dangyogi/midi-expression/README.md

# midi-expression
Combine custom midi expression board with midi-files for real-time performances.
