dangyogi/midi-expression/(list of files, drawings)

Other design files:
exp_console/PCBs/PCB_PCB_LED Controller_2023-10-30.json
