dangyogi/midi-expression/exp_console/PCBs/column-bus/column-bus.kicad_pcb

## KiCad design exp_console/PCBs/column-bus/column-bus.kicad_pcb (2022-09-17)

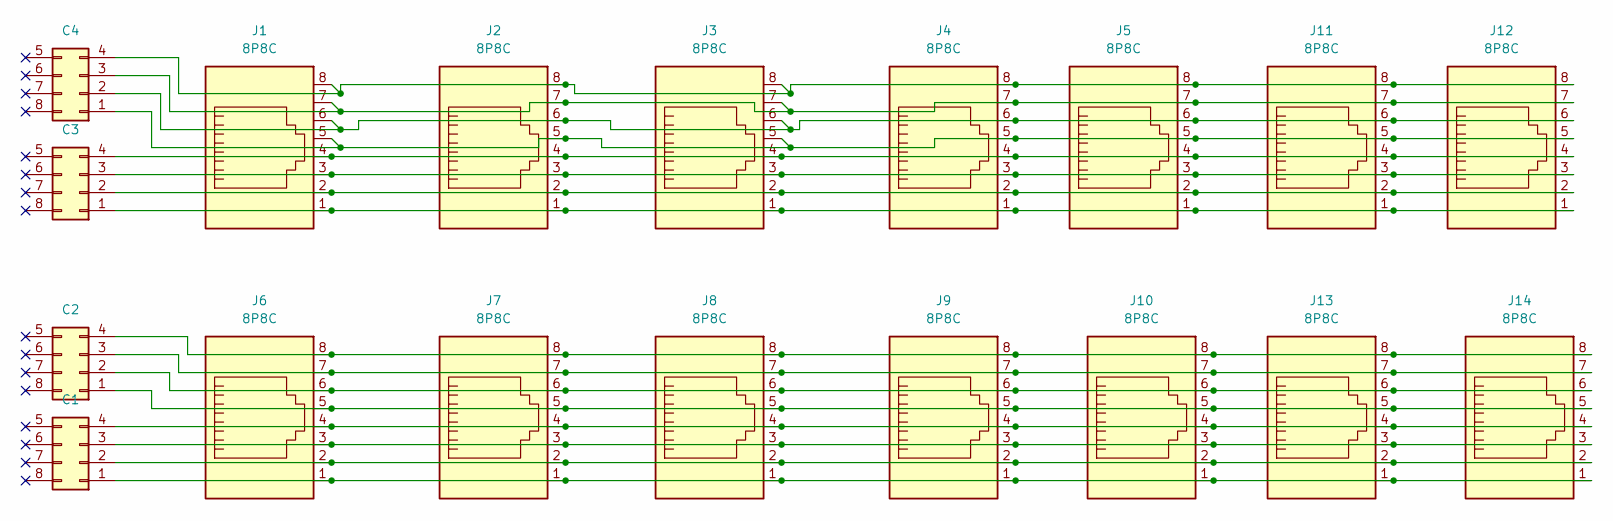
[picture p1: schematic column-bus.kicad_sch]

Parts:
C1, C2, C3, C4: Conn_02x04_Counter_Clockwise; Weidmuller-4-vertical
J1, J2, J3, J4, J5, J6, J7, J8, J9, J10, J11, J12, J13, J14: 8P8C; Wurth-8P8C-Vertical

Connections:
unnamed: C1.1, J6.1, J7.1, J8.1, J9.1, J10.1, J13.1, J14.1
unnamed: C1.2, J6.2, J7.2, J8.2, J9.2, J10.2, J13.2, J14.2
unnamed: C1.3, J6.3, J7.3, J8.3, J9.3, J10.3, J13.3, J14.3
unnamed: C1.4, J6.4, J7.4, J8.4, J9.4, J10.4, J13.4, J14.4
unnamed: C2.1, J6.5, J7.5, J8.5, J9.5, J10.5, J13.5, J14.5
unnamed: C2.2, J6.6, J7.6, J8.6, J9.6, J10.6, J13.6, J14.6
unnamed: C2.3, J6.7, J7.7, J8.7, J9.7, J10.7, J13.7, J14.7
unnamed: C2.4, J6.8, J7.8, J8.8, J9.8, J10.8, J13.8, J14.8
unnamed: C3.1, J1.1, J2.1, J3.1, J4.1, J5.1, J11.1, J12.1
unnamed: C3.2, J1.2, J2.2, J3.2, J4.2, J5.2, J11.2, J12.2
unnamed: C3.3, J1.3, J2.3, J3.3, J4.3, J5.3, J11.3, J12.3
unnamed: C3.4, J1.4, J2.4, J3.4, J4.4, J5.4, J11.4, J12.4
unnamed: C4.1, J1.5, J2.5, J3.5, J4.5, J5.5, J11.5, J12.5
unnamed: C4.2, J1.6, J2.6, J3.6, J4.6, J5.6, J11.6, J12.6
unnamed: C4.3, J1.7, J2.7, J3.7, J4.7, J5.7, J11.7, J12.7
unnamed: C4.4, J1.8, J2.8, J3.8, J4.8, J5.8, J11.8, J12.8

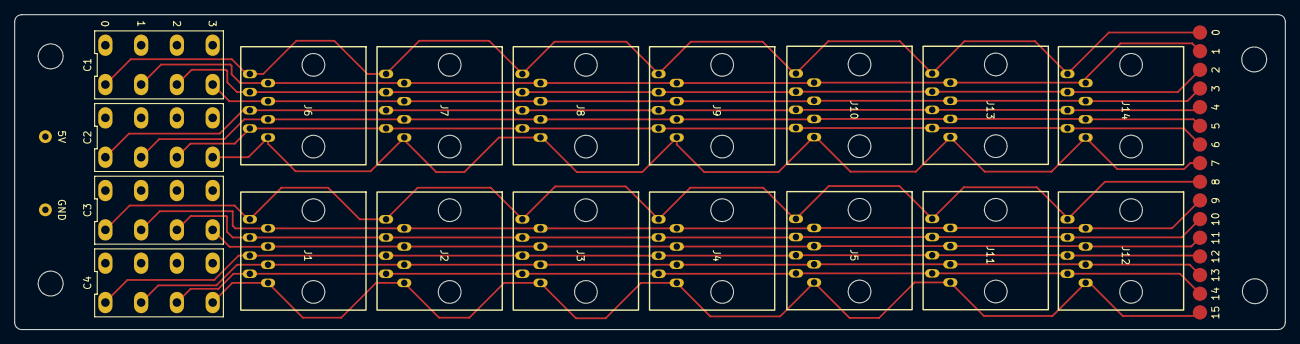
[picture p2: board column-bus.kicad_pcb from above]

Board: 2 copper layers, 177.7 x 44.0 mm, 18 parts (0 on the bottom side), 16 nets.
