dangyogi/midi-expression/exp_console/PCBs/numeric-displays/numeric-displays.kicad_pcb

## KiCad design exp_console/PCBs/numeric-displays/numeric-displays.kicad_pcb (2022-09-17)

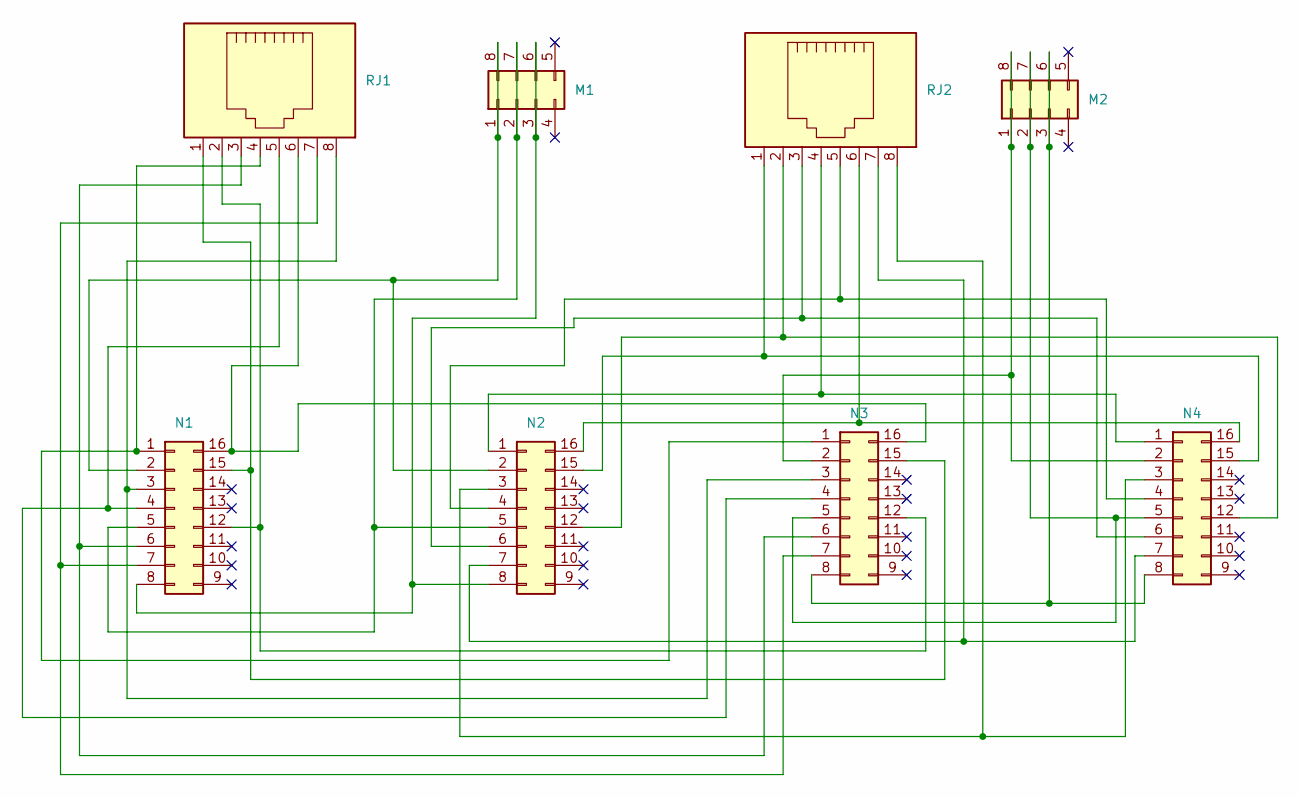
[picture p3: schematic numeric-displays.kicad_sch]

Parts:
M1, M2: Conn_02x04_Counter_Clockwise; Weidmuller-4-vertical
N1, N2, N3, N4: Conn_02x08_Counter_Clockwise; DIP-16_W7.62mm_Socket_LongPads
RJ1, RJ2: 8P8C; Wurth-8P8C-Vertical

Connections:
unnamed: M1.1, M1.8, N1.2, N2.2
unnamed: M1.2, M1.7, N1.5, N2.5
unnamed: M1.3, M1.6, N1.8, N2.8
unnamed: M2.1, M2.8, N3.2, N4.2
unnamed: M2.2, M2.7, N3.5, N4.5
unnamed: M2.3, M2.6, N3.8, N4.8
unnamed: N1.1, N3.1, RJ1.4
unnamed: N1.3, N3.3, RJ1.8
unnamed: N1.4, N3.4, RJ1.5
unnamed: N1.6, N3.6, RJ1.3
unnamed: N1.7, N3.7, RJ1.7
unnamed: N1.12, N3.12, RJ1.2
unnamed: N1.15, N3.15, RJ1.1
unnamed: N1.16, N3.16, RJ1.6
unnamed: N2.1, N4.1, RJ2.4
unnamed: N2.3, N4.3, RJ2.8
unnamed: N2.4, N4.4, RJ2.5
unnamed: N2.6, N4.6, RJ2.3
unnamed: N2.7, N4.7, RJ2.7
unnamed: N2.12, N4.12, RJ2.2
unnamed: N2.15, N4.15, RJ2.1
unnamed: N2.16, N4.16, RJ2.6

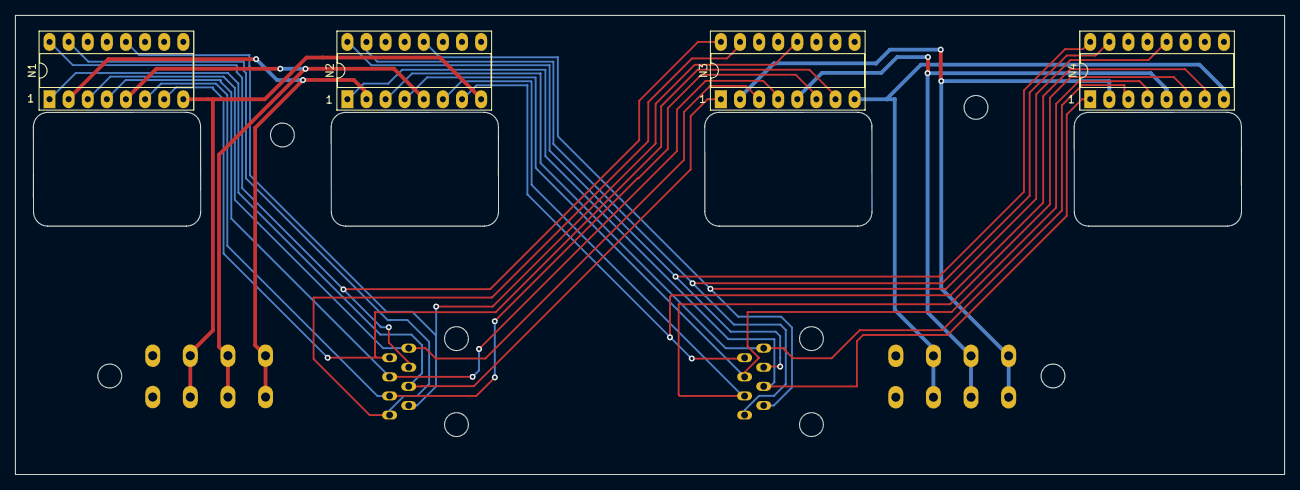
[picture p4: board numeric-displays.kicad_pcb from above]

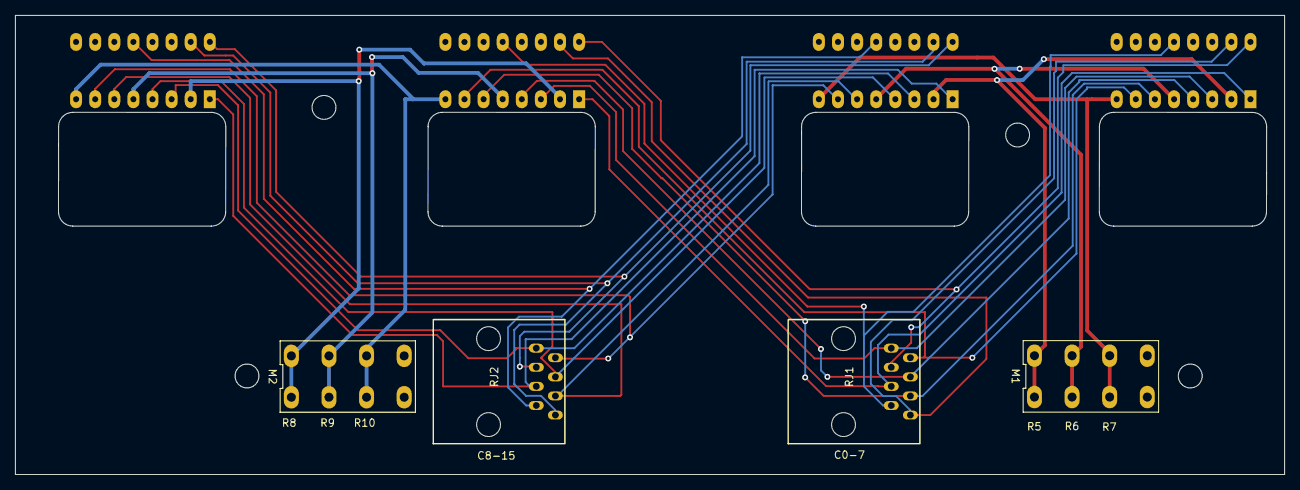
[picture p5: board numeric-displays.kicad_pcb from below]

Board: 2 copper layers, 168.7 x 61.0 mm, 8 parts (4 on the bottom side), 22 nets.
