dangyogi/midi-expression/exp_console/PCBs/alpha-displays/alpha-displays.kicad_pcb

## KiCad design exp_console/PCBs/alpha-displays/alpha-displays.kicad_pcb (2022-09-17)

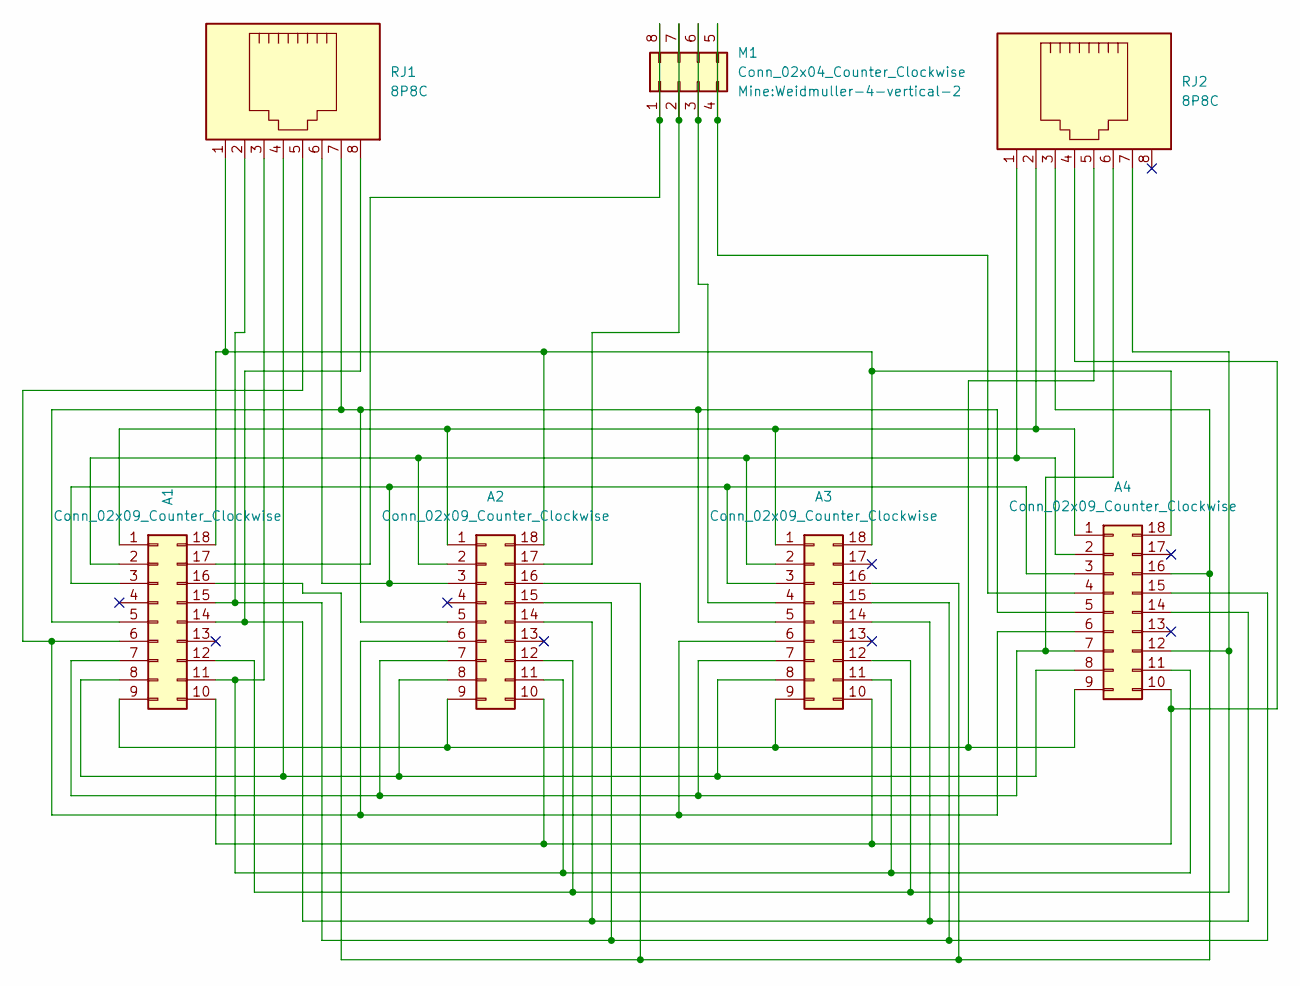
[picture p6: schematic alpha-displays.kicad_sch]

Parts:
A1, A2, A3, A4: Conn_02x09_Counter_Clockwise; DIP-18_W7.62mm_Socket_LongPads
M1: Conn_02x04_Counter_Clockwise; Weidmuller-4-vertical-2
RJ1, RJ2: 8P8C; Wurth-8P8C-Vertical

Connections:
unnamed: A1.1, A2.1, A3.1, A4.1, RJ2.2
unnamed: A1.2, A2.2, A3.2, A4.2, RJ2.1
unnamed: A1.3, A2.3, A3.3, A4.3, RJ1.6
unnamed: A1.5, A2.5, A3.5, A4.5, RJ1.7
unnamed: A1.6, A2.6, A3.6, A4.6, RJ1.5
unnamed: A1.7, A2.7, A3.7, A4.7, RJ2.6
unnamed: A1.8, A2.8, A3.8, A4.8, RJ1.4
unnamed: A1.9, A2.9, A3.9, A4.9, RJ2.5
unnamed: A1.10, A2.10, A3.10, A4.10, RJ2.4
unnamed: A1.11, A2.11, A3.11, A4.11, RJ1.3
unnamed: A1.12, A2.12, A3.12, A4.12, RJ2.7
unnamed: A1.14, A2.14, A3.14, A4.14, RJ1.8
unnamed: A1.15, A2.15, A3.15, A4.15, RJ1.2
unnamed: A1.16, A2.16, A3.16, A4.16, RJ2.3
unnamed: A1.17, M1.1, M1.8
unnamed: A1.18, A2.18, A3.18, A4.18, RJ1.1
unnamed: A2.17, M1.2, M1.7
unnamed: A3.4, M1.3, M1.6
unnamed: A4.4, M1.4, M1.5

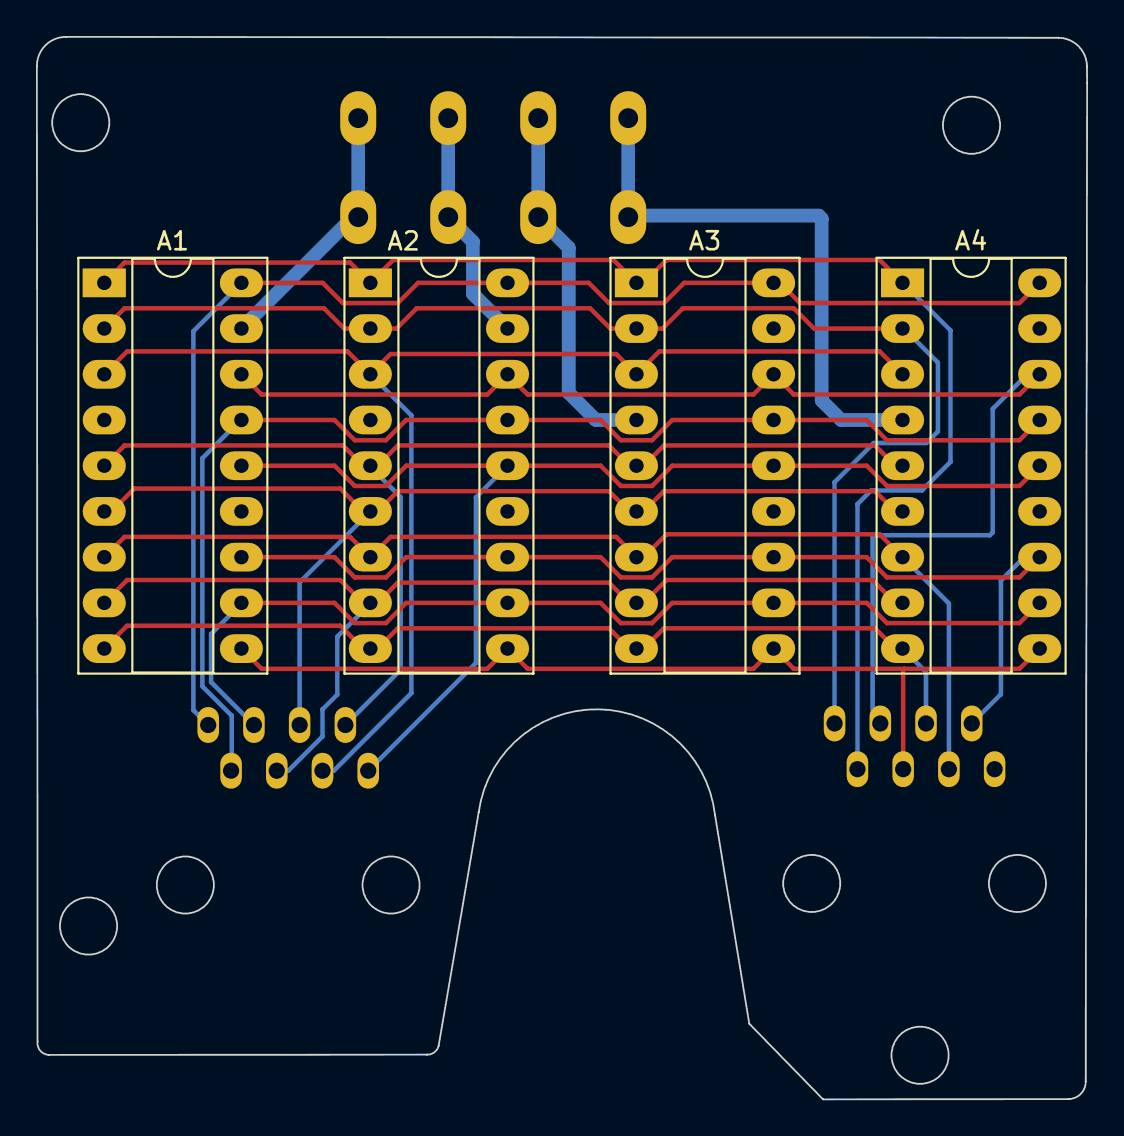
[picture p7: board alpha-displays.kicad_pcb from above]

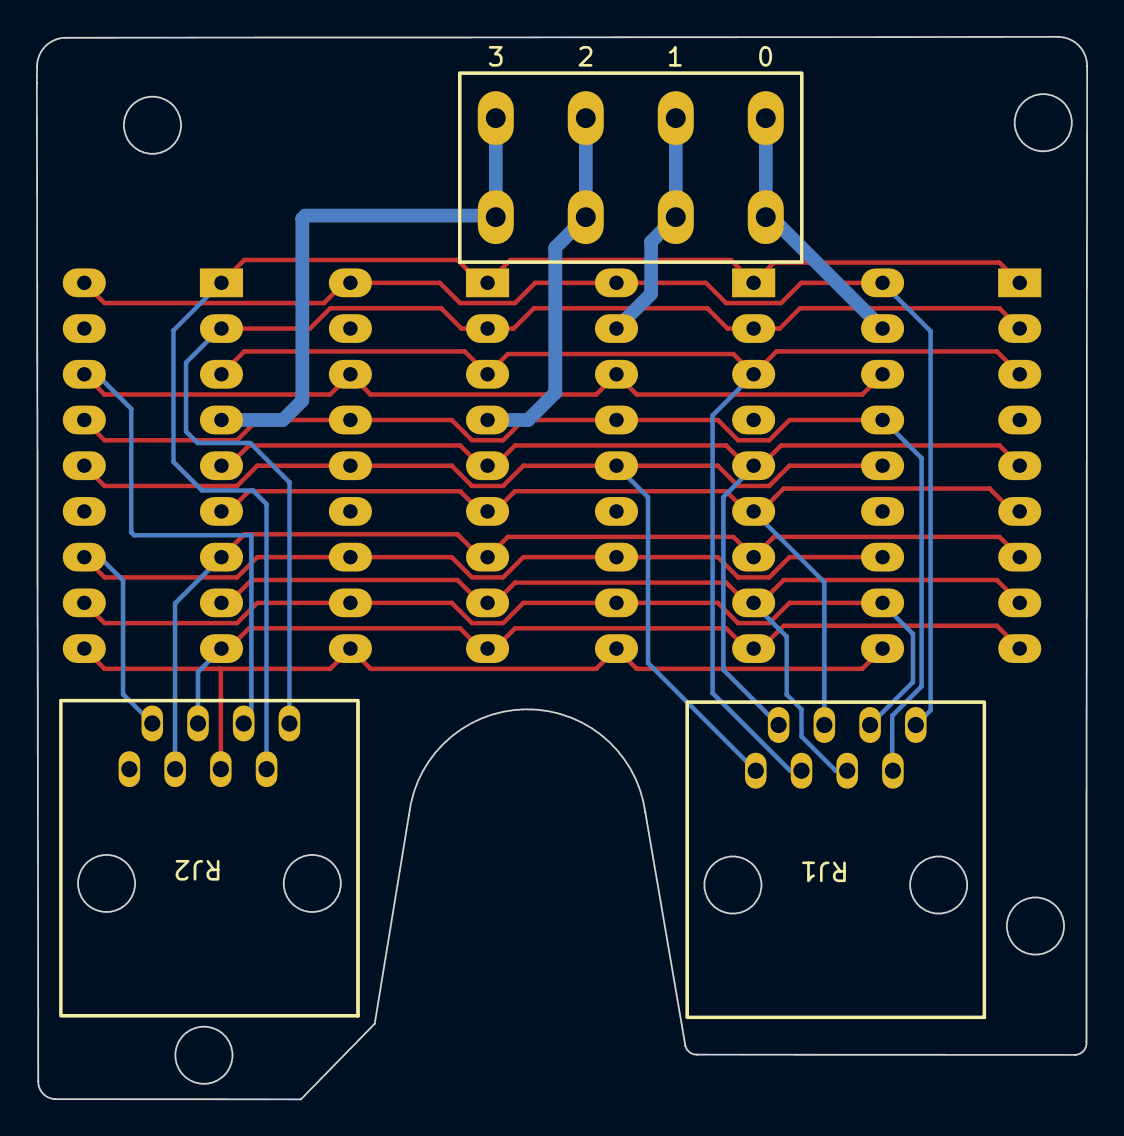
[picture p8: board alpha-displays.kicad_pcb from below]

Board: 2 copper layers, 58.3 x 59.0 mm, 7 parts (3 on the bottom side), 19 nets.
