dangyogi/midi-expression/data/devices.yaml

# devices.yaml

---

I/O Expander:
  part-number: MCP23016-I/SP
  ordered-from: mouser.com
  price: 
  current-drive: 25mA
  supply-voltage: [2, 5.5]
  num-rows: 2
  num-onhand: 10
  socket:
    part-number: 1-2199298-9
    ordered-from: mouser.com
    price: 0.78
    num-onhand: 10
    num-needed: 1
  I2C:
    addr: [0, 1, 0, 0, A2, A1, A0]
    init: []
    commands:
      0x00:
        name: Access GP0
        value-on-reset: [0, 0, 0, 0, 0, 0, 0, 0]
      0x01:
        name: Access GP1
        value-on-reset: [0, 0, 0, 0, 0, 0, 0, 0]
      0x02:
        name: Access OLAT0
        comment: Output Latch Register
        value-on-reset: [0, 0, 0, 0, 0, 0, 0, 0]
      0x03:
        name: Access OLAT1
        comment: Output Latch Register
        value-on-reset: [0, 0, 0, 0, 0, 0, 0, 0]
      0x04:
        name: Access IPOL0
        comment: Input Polarity Register, 1 inverted, 0 not inverted
        value-on-reset: [0, 0, 0, 0, 0, 0, 0, 0]
      0x05:
        name: Access IPOL1
        comment: Input Polarity Register, 1 inverted, 0 not inverted
        value-on-reset: [0, 0, 0, 0, 0, 0, 0, 0]
      0x06:
        name: Access IODIR0
        comment: I/O Direction Register, 1 input, 0 output
        value-on-reset: [1, 1, 1, 1, 1, 1, 1, 1]
      0x07:
        name: Access IODIR1
        comment: I/O Direction Register, 1 input, 0 output
        value-on-reset: [1, 1, 1, 1, 1, 1, 1, 1]
      0x08:
        name: Access INTCAP0
        comment: Interupt Capture Register -- not needed
      0x09:
        name: Access INTCAP1
        comment: Interupt Capture Register -- not needed
      0x0A:
        name: Access IOCON0
        comment: IARES -- Interrupt Activity Resolution, 1 fast sample rate (200uSec), 0 normal sample rate (32mSec)
        bits: [-, -, -, -, -, -, -, IARES]
        value-on-reset: [-, -, -, -, -, -, -, 0]
      0x0B:
        name: Access IOCON1
        bits: [-, -, -, -, -, -, -, IARES]
        value-on-reset: [-, -, -, -, -, -, -, 0]
  fanout-pins: [GP0.0, GP0.1, GP0.2, GP0.3, GP0.4, GP0.5, GP0.6, GP0.7,
                GP1.0, GP1.1, GP1.2, GP1.3, GP1.4, GP1.5, GP1.6, GP1.7]
  pins:
    - name: Vss
      comment: GND
    - name: GP1.0
    - name: GP1.1
    - name: GP1.2
    - name: GP1.3
    - name: INT
      inverted: true
      connect: []
    - name: GP1.4
    - name: Vss
      comment: GND
    - name: CLK
      connect: [[3.9Kohm, Vdd], [33pF, GND]]
    - name: TP
      connect: []
    - name: GP1.5
    - name: GP1.6
    - name: GP1.7
    - name: SCL

    - name: SDA
    - name: A0
    - name: A1
    - name: A2
    - name: Vss
      connect: [[GND]]
    - name: Vdd
      connect: [[.1uF, GND]]
    - name: GP0.0
    - name: GP0.1
    - name: GP0.2
    - name: GP0.3
    - name: GP0.4
    - name: GP0.5
    - name: GP0.6
    - name: GP0.7


I/O Expander Input:
  uses: I/O Expander
  I2C:
    init: []
  pins:
    - name: GP1.0
      connect: [[20Kohm, Vdd]]
    - name: GP1.1
      connect: [[20Kohm, Vdd]]
    - name: GP1.2
      connect: [[20Kohm, Vdd]]
    - name: GP1.3
      connect: [[20Kohm, Vdd]]
    - name: GP1.4
      connect: [[20Kohm, Vdd]]
    - name: GP1.5
      connect: [[20Kohm, Vdd]]
    - name: GP1.6
      connect: [[20Kohm, Vdd]]
    - name: GP1.7
      connect: [[20Kohm, Vdd]]
    - name: GP0.7
      connect: [[20Kohm, Vdd]]
    - name: GP0.6
      connect: [[20Kohm, Vdd]]
    - name: GP0.5
      connect: [[20Kohm, Vdd]]
    - name: GP0.4
      connect: [[20Kohm, Vdd]]
    - name: GP0.3
      connect: [[20Kohm, Vdd]]
    - name: GP0.2
      connect: [[20Kohm, Vdd]]
    - name: GP0.1
      connect: [[20Kohm, Vdd]]
    - name: GP0.0
      connect: [[20Kohm, Vdd]]

I/O Expander Output:
  uses: I/O Expander
  I2C:
    init: [[Access IODIR0, 0x00, 0x00]]
  pins:
    - name: GP1.0
      connect: [[120ohm, series]]
    - name: GP1.1
      connect: [[120ohm, series]]
    - name: GP1.2
      connect: [[120ohm, series]]
    - name: GP1.3
      connect: [[120ohm, series]]
    - name: GP1.4
      connect: [[120ohm, series]]
    - name: GP1.5
      connect: [[120ohm, series]]
    - name: GP1.6
      connect: [[120ohm, series]]
    - name: GP1.7
      connect: [[120ohm, series]]
    - name: GP0.7
      connect: [[120ohm, series]]
    - name: GP0.6
      connect: [[120ohm, series]]
    - name: GP0.5
      connect: [[120ohm, series]]
    - name: GP0.4
      connect: [[120ohm, series]]
    - name: GP0.3
      connect: [[120ohm, series]]
    - name: GP0.2
      connect: [[120ohm, series]]
    - name: GP0.1
      connect: [[120ohm, series]]
    - name: GP0.0
      connect: [[120ohm, series]]

Multiplexer:
  part-number: MAX4617CPE+
  ordered-from: mouser.com
  price: 4.48
  num-onhand: 13
  supply-voltage: [2, 5.5]
  output-pins: [X0, X1, X2, X3, X4, X5, X6, X7]
  num-pins: 8
  num-rows: 2
  socket:
    part-number: 110-47-316-41-001000
    num-pins: 16
    num-onhand: 15
    ordered-from: mouser.com
    price: 1.10
    number-needed: 1
  fanout-pins: [X0, X1, X2, X3, X4, X5, X6, X7]
  pins:
    - name: X4
    - name: X6
    - name: X
    - name: X7
    - name: X5
    - name: ENABLE
      connect: [[GND]]
    - name: N.C.
      connect: []
    - name: GND
      connect: [[GND]]

    - name: C
      comment: MSb
    - name: B
    - name: A
      comment: LSb
    - name: X3
    - name: X0
    - name: X1
    - name: X2
    - name: Vcc
      connect: [[.1uF, GND]]

Counter:
  part-number: CD74HCT161EE4
  mouser-number: 595-CD74HCT161EE4
  ordered-from: mouser.com
  price: 0.62
  supply-voltage: [4.5, 5.5]
  output-pins: [Q0, Q1, Q2, Q3]
  num-pins: 16
  num-rows: 2
  socket:
    part-number: 110-47-316-41-001000
    ordered-from: mouser.com
    price: 1.10
    num-needed: 1
  pins:
    - name: MR
      inverted: true
      comment: master reset, independent of clock, 30nSec pulse width
    - name: CP
      comment: clock, triggers on transition to high, 25nSec pulse width
    - name: P0
      connect: [[GND]]
    - name: P1
      connect: [[GND]]
    - name: P2
      connect: [[GND]]
    - name: P3
      connect: [[GND]]
    - name: PE
      connect: [[Vcc]]
    - name: GND
      connect: [[GND]]

    - name: Vcc
      connect: [[.1uF, GND]]
    - name: TC
      comment: no connection
    - name: Q0
    - name: Q1
    - name: Q2
    - name: Q3
    - name: TE
      connect: [[Vcc]]
    - name: SPE
      inverted: true
      connect: [[Vcc]]

Demultiplexer:
  part-number: SN74HC138N
  mouser-number: 595-SN74HC138N
  ordered-from: mouser.com
  price: 0.60
  supply-voltage: [2, 6]
  comment: address selectable low line out of 8 high outputs
  output-drive: +/- 4mA
  output-pins: [Y0, Y1, Y2, Y3, Y4, Y5, Y6, Y7]
  num-pins: 16
  num-rows: 2
  fanout-pins: [Y0, Y1, Y2, Y3, Y4, Y5, Y6, Y7]
  socket:
    part-number: 110-47-316-41-001000
    ordered-from: mouser.com
    price: 1.10
    number-needed: 1
  pins:
    - name: A
    - name: B
    - name: C
    - name: G2A
      inverted: true
      comment: must be low, or all outputs are high
    - name: G2B
      inverted: true
      comment: must be low, or all outputs are high
    - name: G1
      comment: must be high, or all outputs are high
    - name: Y7
    - name: GND
      connect: [[GND]]

    - name: Y6
    - name: Y5
    - name: Y4
    - name: Y3
    - name: Y2
    - name: Y1
    - name: Y0
    - name: Vcc
      connect: [[.1uF, GND]]

Slide Pot:
  part-number: SLP-50K
  ordered-from: allelectronics.com
  price: 0.50
  num-onhand: 25
  length: 3 3/8
  width: 3/4
  slide-slot-length: 2 5/8
  screw-size: 4-40
  screw-hole-size: 0.116"
  knob:
    part-number: KNB-297
    ordered-from: allelectronics.com
    price: 0.40
  num-rows: 1
  pin-connect: wiper
  pins:
    - name: high-rail
    - name: wiper
    - name: low-rail
      connect: [[GND]]

Rotary Switch:
  part-number: RSW-112
  ordered-from: allelectronics.com
  price: 2.00
  num-onhand: 7
  positions: 12
  fanout-pins: [P1, P2, P3, P4, P5, P6, P7, P8, P9, P10, P11, P12]
  num-rows: 1
  pins:
    - name: P1
    - name: P2
    - name: P3
    - name: P4
    - name: P5
    - name: P6
    - name: P7
    - name: P8
    - name: P9
    - name: P10
    - name: P11
    - name: P12
    - name: wiper
      connect: [[GND]]

Toggle Switch:
  part-number: STS-130
  ordered-from: allelectronics.com
  price: 1.75
  num-onhand: 35
  type: SPST
  num-rows: 1
  hole-size: 0.47"
  open: toggle on slot side
  pin-connect: p1
  pins:
    - name: p1
    - name: p2
      connect: [[+diode, series]]
      comment: positive side of switch

Rotary Encoder:
  part-number: RE-66
  ordered-from: allelectronics.com
  price: 1.75
  num-onhand: 15
  detents: 20
  hole-size: 0.27
  fanout-pins: [A, B, Bt]
  num-rows: 1
  pins:
    - name: A
    - name: center
      connect: [[+diode, series]]
      comment: positive side of switch
    - name: B
    - name: Bt
    - name: Bt2
      connect: [[+diode, series]]
      comment: positive side of switch

LED:
  part-number: LED-10R
  ordered-from: allelectronics.com
  price: 0.10
  num-onhand: 40
  color: red
  brightness: brighter
  hole-size: 3/16
  pin-connect: long
  num-rows: 1
  pins:
    - name: anode
      comment: positive
      connect: []
    - name: cathode
      comment: negative
      connect: [[GND]]

Button:
  part-number: SB4011NOHC
  mouser-number: 633-SB4011NOHC
  ordered-from: mouser.com
  price: 4.51
  num-onhand: 16
  normally: open
  hole-size: 0.47"
  pin-connect: p1
  num-rows: 1
  pins:
    - name: p1
    - name: p2
      connect: [[+diode, series]]
      comment: positive side of switch

LCD:
  part-number: HDM16216H-5-S00S
  ordered-from: mouser.com
  price: 10.10
  num-onhand: 1
  controller: HD44780 or equivalent
  socket:
    part-number: 61301611821
    ordered-from: mouser.com
    price: 0.69
    num-onhand: 1
    num-needed: 1
  num-rows: 1
  pins:
    - name: Vss
      connect: [[GND]]
    - name: Vdd
      connect: [[.1uF, GND]]
    - name: Vl
    - name: RS
    - name: R/W
    - name: E
    - name: D0
    - name: D1
    - name: D2
    - name: D3
    - name: D4
    - name: D5
    - name: D6
    - name: D7
    - name: NC
      connect: []
      comment: no connection
    - name: NC
      connect: []
      comment: no connection

Rotary Pot:
  part-number: P160KNPD-4FC20B10K
  ordered-from: mouser.com
  price: 0.86
  num-onhand: 1
  ohms: 10k
  taper: linear
  num-rows: 1
  pins:
    - name: high-rail
    - name: wiper
    - name: low-rail

Nano Every:
  ordered-from: arduino.cc
  price: 27.90 for 3 pack
  num-onhand: 3
  microcontroller: ATMega4809
  flash: 48KB
  sram: 6KB
  EEPROM: 256B
  voltage: 5V
  max-total-current: 950mA
  max-GPIO-current: 15mA
  max-pin-group-current: 100mA at 125C, 200mA at 25C, source or sink
  pull-up-resistor: 35kohm
  max-spi-clock: 10MHz master, 5MHz slave
  max-i2c-clock: 1MHz
  clock: 16MHz
  embedded-sensors: []
  num-rows: 2
  socket:
    part-number: PRT-16279
    ordered-from: mouser.com
    price: 1.50
    type: female header
    number-needed: 2
  internal:
    # these skip A4 and A5 because they have two internal pins, can get into trouble...
    PA: [D2, D7]
    PB: [D9, D10, D5]
    PC: [TX, RX, D4]
    PD: [A3, A2, A1, A0, A6, A7, AREF]
    PE: [D11, D12, D13, D8]
    PF: [D6, D3]
  pins:
    - name: D13
      comment: built-in LED
      aka: PE2
    - name: 3V3
      comment: max output 200mA
    - name: AREF
      aka: PD7
    - name: A0
      number: 14
      aka: PD3
    - name: A1
      number: 15
      aka: PD2
    - name: A2
      number: 16
      aka: PD1
    - name: A3
      number: 17
      aka: PD0
    - name: A4
      number: 18
      aka: SDA
    - name: A5
      number: 19
      aka: SCL
    - name: A6
      number: 20
      aka: PD4
    - name: A7
      number: 21
      aka: PD5
    - name: 5V
      connect: [[.1uF, GND]]
      comment: max output 1A
    - name: RESET
      inverted: true
      connect: []
    - name: GND
    - name: VIN
      connect: [[12V], [.1uF, GND]]
      comment: 7-18VDC

    - name: TX
      number: 1
      aka: PC4
    - name: RX
      number: 0
      aka: PC5
    - name: RESET
      inverted: true
      connect: []
    - name: GND2
    - name: D2
      aka: PA0
    - name: D3
      aka: PF5
    - name: D4
      aka: PC6
    - name: D5
      aka: PB2
    - name: D6
      aka: PF4
    - name: D7
      aka: PA1
    - name: D8
      aka: PE3
    - name: D9
      aka: PB0
    - name: D10
      aka: PB1
    - name: D11
      aka: PE0
    - name: D12
      aka: PE1

  aka-registers-by-pin:

    - name: D2
      aka: PA0
    - name: D7
      aka: PA1

    - name: D9
      aka: PB0
    - name: D10
      aka: PB1
    - name: D5
      aka: PB2

    - name: TX
      number: 1
      aka: PC4
    - name: RX
      number: 0
      aka: PC5
    - name: D4
      aka: PC6

    - name: A3
      number: 17
      aka: PD0
    - name: A2
      number: 16
      aka: PD1
    - name: A1
      number: 15
      aka: PD2
    - name: A0
      number: 14
      aka: PD3
    - name: A6
      number: 20
      aka: PD4
    - name: A7
      number: 21
      aka: PD5
    - name: AREF
      aka: PD7

    - name: D11
      aka: PE0
    - name: D12
      aka: PE1
    - name: D13
      comment: built-in LED
      aka: PE2
    - name: D8
      aka: PE3

    - name: D6
      aka: PF4
    - name: D3
      aka: PF5


Nano 33 IoT:
  ordered-from: arduino.cc
  price: 19.40
  num-onhand: 3
  microcontroller: SAMD21
  flash: 264KB
  sram: 256KB
  EEPROM: null
  voltage: 3.3V
  clock: 48MHz
  max-i2c-clock: 3.4MHz
  max-GPIO-current: 7mA
  pull-up-resistor: 40kohm
  embedded-sensors: [LSM6DS3]
  num-rows: 2
  socket:
    part-number: PRT-16279
    ordered-from: mouser.com
    price: 1.50
    type: female header
    number-needed: 2
  pins:
    - name: D13
      aka: PA17
      comment: built-in LED
    - name: 3V3
    - name: AREF
      aka: PA03
    - name: A0
      aka: PA02
      number: 14
    - name: A1
      aka: PB02
      number: 15
    - name: A2
      aka: PA11
      number: 16
    - name: A3
      aka: PA10
      number: 17
    - name: A4
      number: 18
      aka: SDA
    - name: A5
      number: 19
      aka: SCL
    - name: A6
      aka: PA09
      number: 20
    - name: A7
      aka: PB03
      number: 21
    - name: 5V
      comment: ONLY active if both powered by USB and solder bridge is in place
    - name: RESET
      inverted: true
      connect: []
    - name: GND
    - name: VIN
      comment: 5-18VDC
      connect: [[12V], [.1uF, GND]]

    - name: TX
      aka: PB22
      number: 1
    - name: RX
      aka: PB23
      number: 0
    - name: RESET
      inverted: true
      connect: []
    - name: GND2
    - name: D2
      aka: PB10
    - name: D3
      aka: PB11
    - name: D4
      aka: PA07
    - name: D5
      aka: PA05
    - name: D6
      aka: PA04
    - name: D7
      aka: PA06
    - name: D8
      aka: PA18
    - name: D9
      aka: PA20
    - name: D10
      aka: PA21
    - name: D11
      aka: PA16
    - name: D12
      aka: PA19

  internal-registers-by-pin:
    - name: A0
      aka: PA02
    - name: AREF
      aka: PA03
    - name: D6
      aka: PA04
    - name: D5
      aka: PA05
    - name: D7
      aka: PA06
    - name: D4
      aka: PA07

    - name: A6
      aka: PA09
    - name: A3
      aka: PA10
    - name: A2
      aka: PA11

    - name: D11
      aka: PA16
    - name: D13
      aka: PA17
      comment: built-in LED
    - name: D8
      aka: PA18
    - name: D12
      aka: PA19
    - name: D9
      aka: PA20
    - name: D10
      aka: PA21

    - name: A1
      aka: PB02
    - name: A7
      aka: PB03

    - name: D2
      aka: PB10
    - name: D3
      aka: PB11

    - name: TX
      aka: PB22
    - name: RX
      aka: PB23

    - name: A4
      aka: SDA
    - name: A5
      aka: SCL


I2C-level-converter:
  num-rows: 2
  row-spacing: 0.4"
  socket:
    part-number: 310-87-106-41-001101
    ordered-from: mouser.com
    price: 0.48
    type: female header
    number-needed: 2
  pins:
    - name: LV1
    - name: LV2
    - name: LV
      connect: [[.1uF, LV-GND]]
    - name: LV-GND
    - name: LV3
    - name: LV4

    - name: HV4
    - name: HV3
    - name: HV-GND
    - name: HV
      connect: [[.1uF, HV-GND]]
    - name: HV2
    - name: HV1

LED-numeric-display:
  part-number: TDA-26
  mfc-part-number: LTC-2621G
  ordered-from: allelectronics.com
  price: 0.85
  num-onhand: 15
  num-digits: 3
  color: green
  length: 0.891"
  width: 0.394"
  height: 0.24"
  pins: 16
  num-rows: 2
  pitch: 0.1"
  distance-between-rows: 0.3"
  voltage: 2.1V
  current: 20mA
  pulsed-current: 100mA
  duty-cycle: 10%
  max-pulse-width: 0.1mSec
  common: anode (+)
  segments: A on top, then clockwise around the edges to F and G in the center
  pins:
    - name: D
    - name: digit-1      # + side of segments A-G and DP
    - name: DP
    - name: E
    - name: digit-2
    - name: C
    - name: G
    - name: digit-3

    - name: N.C.
    - name: no-pin
    - name: no-pin
    - name: B
    - name: digit-L1-L2-L3 # don't care about these...
    - name: no-pin
    - name: A
    - name: F

LED-alpha-display:
  part-number: SDA-24
  mfc-part-number: LA3921-11B
  ordered-from: allelectronics.com
  price: 0.50
  num-onhand: 20
  num-segments: 14 + DP
  color: green
  length: 0.929" (measured at 15/16-)
  width: 0.390" (measured at 3/8)
  height: 0.276"
  pins: 18
  num-rows: 2
  pitch: 0.1"
  distance-between-rows: 0.3"
  voltage: 2.1V
  current: 30mA "per chip"
  pulsed-current: 100mA "per chip"
  duty-cycle: 10%
  max-pulse-width: 0.1mSec
  common: anode (+)
  segments: A on top, then clockwise around the edges to F and G1, G2 in the center
            then H thru M starting at upper left for internal "star" segments
  pins:
    - name: I
    - name: H
    - name: F
    - name: common-anodes
    - name: G1
    - name: E
    - name: M
    - name: D
    - name: L

    - name: K
    - name: C
    - name: DP
    - name: common-anodes2
      comment: tied to common-anodes internally
    - name: G2
    - name: B
    - name: J
    - name: common-anodes3
      comment: tied to common-anodes internally
    - name: A

MOSFET-P-channel:
  part-number: FQP7P06
  mouser-number: 512-FQP7P06
  ordered-from: mouser.com
  price: 1.41
  num-onhand: 18
  voltage: 60V
  current: 7A
  on-resistance: max 410 mOhms
  gate-source-voltage: 3.8V for 1A (from graph)
  source: high
  pitch: 0.1"
  pins:   # Tab down, left to right
    - name: gate
    - name: drain
    - name: source

MOSFET-P-channel-obs:
  part-number: IRFD9024PBF
  mouser-number: 844-IRFD9024PBF
  ordered-from: mouser.com
  price: 1.85
  num-onhand: 10
  voltage: 60V
  current: 1.6A
  on-resistance: 280 mOhms
  gate-source-voltage:
    - voltage: -4V
      drain-current: 0.45A   # looks like 10mA on graph... :-(
    - voltage: -5V
      drain-current: 2A
    - voltage: -6V
      drain-current: 5.5A
  source: high
  package: 4 pin DIP
  pitch: 0.1"
  row-distance: 0.3"
  num-rows: 2
  pins:   # The two drain pins are tied together outside the package.
    - name: drain
    - name: drain2
    - name: gate
    - name: source

Bipolar-NPN:
  part-number: BC548C B1G
  mouser-number: 821-BC548CB1G
  ordered-from: mouser.com
  price: 0.19
  num-onhand: 70
  voltage: 30V
  current-continuous: 100mA
  current-peak: 200mA
  Vce: 150mV at 100mA Ic
  Vbe:  # Vce 5V
    - Ic: 0.5mA
      Vbe: 0.58V
    - Ic: 100mA
      Vbe: 0.8V   # 0.9V at sat
  power-dissipation: 500mW
  hFE: 200  # probably more 400
  emitter-follower:
    - target-current: 100mA
    - E-resistor: 10ohm  # target 1V
    - E-voltage: 1V
    - B-voltage: 1.8V
    - B-bias-resistors:
        B-current: 0.5mA
        Bias-resistor-current: 10mA  # 20x to get ~5% B-current affect
        Total-bias-resistor: 500ohm
        B-GND-resistor: 180ohm
        B-5V-resistor: 320ohm
  num-rows: 1
  pins:  # flat side up, left to right
    - name: C
      comment: |
        2.55V across resistor to LED (figuring 5V supply, 0.2V for MOSFET,
        2.1V for LED, and 0.15V for transistor) this gives:
          255ohm for 10mA
          128ohm for 20mA
           53ohm for 48mA (== 3 * 16)
           41ohm for 62.5mA (== 3.9 * 16, x16 == 1A)
           34ohm for 75mA
           32.4ohm for 79mA (x16 == 1.26A) 
           26ohm for 100mA
    - name: B
      comment: |
        4.1Kohm resistor gives 1mA base current at 5V
        2.4Kohm resistor gives 1mA base current at 3.3V
    - name: E
      connect: [[GND]]

Diode:
  part-number: 1N914BTR
  mouser-number: 512-1N914BTR
  ordered-from: mouser.com
  price: 0.10
  pins:
    - name: anode
      comment: positive
    - name: cathode
      comment: negative, banded

Breadboard:
  part-number: SB404
  ordered-from: mouser.com
  num-onhand: 7
  price: 5.00
  length: 3.75 in
  width: 1.85 in
  number-of-rows: 36

Little-stuff:
  "33pF":
    num-onhand: 15
  ".1uF":
    num-onhand: 20
  "20kohm":
    num-onhand: 120
  "3.9kohm":
    num-onhand: 20
  "300ohm":
    num-onhand: 100
  "150ohm":
    num-onhand: 100
  "120ohm":
    num-onhand: 100
  "32.4ohm":
    num-onhand: 10
  "8.2ohm":
    num-onhand: 20


# vim: sw=2 ic
