dangyogi/midi-expression/exp_console/sketch_master/encoders.h

// encoders.h

#define ENCODER_FLAGS_DISABLED      1
#define ENCODER_FLAGS_CYCLE         2
#define ENCODER_FLAGS_CHOICE_LEDS   4

// Every parameter type has one of these:
typedef struct var_type_s {
  var_type_s(byte _max, byte _display_value = 0xFF, byte _flags = 0, byte _bt_mul_down = 1,
             byte _min = 0, byte _bt_mul_up = 1) {
    min = _min;
    max = _max;
    display_value = _display_value;
    flags = _flags;
    bt_mul[0] = _bt_mul_up;
    bt_mul[1] = _bt_mul_down;
  }
  byte min, max;
  byte display_value;   // sent to run_event with enc, 0xFF is None
  byte flags;           // See ENCODER_FLAGS_<X> #defines
  byte bt_mul[2];       // button: up, down
} var_type_t;
 
// Every parameter has one of these:
typedef struct {
  var_type_t *var_type;
  byte value;           // initially set to default value, copied to memory in setup_functions.
  byte changed;         // set to 1 each time value changes.  Used by SWITCH_REPORT, which resets it.
} variable_t;

// Every encoder has one of these:
typedef struct {
  byte A_sw;            // A_sw, B_sw, Button are consecutive column numbers
  byte display_num;     // numeric disp# (ignored when ENCODER_FLAGS_CHOICE_LEDS is set)
  byte encoder_event;   // process encoder changes (display_value event updates display) 0xFF is None
  signed char count;
  variable_t *var;      // disabled if NULL
} encoder_t;

typedef struct choices_s: var_type_s {
  choices_s(byte _choices_num, byte _choices_length, byte _bt_mul_down = 1, byte _additional_flags = 0)
    : var_type_s(_choices_length - 1, UPDATE_CHOICES, _additional_flags | ENCODER_FLAGS_CHOICE_LEDS, _bt_mul_down)
  {
    choices_num = _choices_num;
  }
  byte choices_num;
} choices_t;

typedef struct sharps_flats_s: var_type_s {
  sharps_flats_s(void)
    : var_type_s(14, UPDATE_SHARPS_FLATS, 0, 4)
  {
  }
} sharps_flats_t;

typedef struct linear_number_s: var_type_s {
  linear_number_s(byte _min, byte _max, long _offset = 0, byte _bt_mul_down = 1, byte _dp = 0,
                  long _scale = 1, byte _extra_10s = 0, byte _trim = 0, byte _flags = 0)
    : var_type_s(_max, UPDATE_LINEAR_NUM, _flags, _bt_mul_down, _min)
  {
    scale = _scale;
    offset = _offset;
    dp = _dp;
    extra_10s = _extra_10s;
    trim = _trim;
  }
  long scale;      // encoder value multiplied by 10^abs(dp), then divided by scale (rounded)
  long offset;
  byte dp;         // decimal point position. Negative shifts left and is ignored on display.
  byte extra_10s;  // extra powers of ten to multiply by before applying scale.
  byte trim;       // true/false, if true leading digits are trimmed.
} linear_number_t;

typedef struct geometric_number_s: var_type_s {
  geometric_number_s(byte _max, float _limit, float _b, float _start = 0.0, byte _bt_mul_down = 1)
    : var_type_s(_max, UPDATE_GEOMETRIC_NUM, 0, _bt_mul_down)
  {
    b = _b;
    m = log((_limit - _start) / exp(_b) + 1) / _max;
    c = _start - exp(_b);
  }
  float m;  // display value is: e**(m*value + b) + c
  float b;
  float c;
} geometric_number_t;

typedef struct note_s: var_type_s {
  // C, "C#", D, Eb, E, F, "F#", G, Ab, A, Bb, B, [NULL]
  // Eb, Ab
  note_s(byte _num_notes, const char **_notes, byte _include_null = 0, byte _flags = 0, byte _min = 0)
    : var_type_s(_min + _num_notes - 1 + _include_null, UPDATE_NOTE, _flags, 1, _min, 1)
  {
    num_notes = _num_notes;
    include_null = _include_null;
    notes = _notes;
    if (num_notes > 7) bt_mul[1] = 3;
  }
  byte num_notes;
  byte include_null;
  const char **notes; // e.g., "C#"
} note_t;

#define NUM_ENCODERS    6

extern encoder_t Encoders[NUM_ENCODERS];

#define FUNCTION_ENCODER   4
#define FILENAME_ENCODER   5

#define FUNCTION   (Encoders[FUNCTION_ENCODER].var->value)

extern void send_LED_request(byte *msg, byte length);
extern void led_on(byte led);
extern void led_off(byte led);

extern var_type_t Disabled;
extern variable_t Filename_var;
extern variable_t Function_var;

extern void select_led(byte enc);
extern void turn_off_choices_leds(byte enc);
extern void display_number(byte display_num, short num, byte dp);
extern void clear_numeric_display(byte display_num);
extern void display_linear_number(byte enc);
extern void display_geometric_number(byte enc);
extern void display_note(byte enc);
extern void display_sharps_flats(byte enc);

extern byte setup_encoders(byte EEPROM_offset);

// vim: sw=2
