dangyogi/midi-expression/data/player_settings.yaml

# player_settings.yaml

---

Player:
  cable: 1

  Ignore_control_codes: [0x01, 0x06, 0x0A, 0x0B,
             # 0x0E, 0x0F,   # What are these???
             0x26, 0x40, 0x60, 0x61, 0x62, 0x63, 0x64, 0x65, 0x79, 0x7B]

  # Unassigned_control_codes: 0x03, 0x09, 0x0E-0x0F, 0x14-0x1F (12),
  #   from repeating numbers: 0x23, 0x29, 0x2E-0x2F, 0x34-0x3F (12),
  #                           0x50-0x5A (11), 0x5C, 0x5E-0x5F, 0x66-0x77 (17)

  Settings:
    volume:
      parameters:
        - level:
            range: [0, 90]  # 7 bits
            units: dB
            to_python:
              as_percent_of: 90
      control_change: 0x07

    tempo:
      parameters:
        - offset:       # targeting 1/5 - 5
            progression: geom
            start: 0.20
            limit: 5
            bits: 7
      control_change: 0x14

    channel-volume:
      parameters:
        - offset:       # targeting +/- 20 dB
            range: [-20, 20]  # 6 bits
            steps_per_unit: 1
            units: dB
      control_change: 0x15

    channel-note-on-delay:
      parameters:
        - delay:       # targeting +/- 300 mSec
            units: mSec
            range: [-300, 300]  # 6 bits
            steps_per_unit: 10
      control_change: 0x16

    channel-note-off-delay:
      parameters:
        - delay:       # targeting +/- 300 mSec
            units: mSec
            range: [-300, 300]  # 6 bits
            steps_per_unit: 10
      control_change: 0x17

    chord-vol-1:
      parameters:
        - offset:       # targeting +/- 20 dB
            range: [-20, 20]    # 6 bits
            steps_per_unit: 1
            units: dB
      control_change: 0x18

    chord-note-on-delay-1:
      parameters:
        - delay:       # targeting +/- 300 mSec
            units: mSec
            range: [-300, 300]  # 6 bits
            steps_per_unit: 10
      control_change: 0x19

    chord-note-off-delay-1:
      parameters:
        - delay:       # targeting +/- 300 mSec
            units: mSec
            range: [-300, 300]  # 6 bits
            steps_per_unit: 10
      control_change: 0x1A

    chord-vol-2:
      parameters:
        - offset:       # targeting +/- 20 dB
            range: [-20, 20]    # 6 bits
            steps_per_unit: 1
            units: dB
      control_change: 0x1B

    chord-note-on-delay-2:
      parameters:
        - delay:       # targeting +/- 300 mSec
            units: mSec
            range: [-300, 300]  # 6 bits
            steps_per_unit: 10
      control_change: 0x1C

    chord-note-off-delay-2:
      parameters:
        - delay:       # targeting +/- 300 mSec
            units: mSec
            range: [-300, 300]  # 6 bits
            steps_per_unit: 10
      control_change: 0x1D

    chord-vol-3:
      parameters:
        - offset:       # targeting +/- 20 dB
            range: [-20, 20]    # 6 bits
            steps_per_unit: 1
            units: dB
      control_change: 0x1E

    chord-note-on-delay-3:
      parameters:
        - delay:       # targeting +/- 300 mSec
            units: mSec
            range: [-300, 300]  # 6 bits
            steps_per_unit: 10
      control_change: 0x1F

    chord-note-off-delay-3:
      parameters:
        - delay:       # targeting +/- 300 mSec
            units: mSec
            range: [-300, 300]  # 6 bits
            steps_per_unit: 10
      control_change: 0x34

    chord-vol-4:
      parameters:
        - offset:       # targeting +/- 20 dB
            range: [-20, 20]    # 6 bits
            steps_per_unit: 1
            units: dB
      control_change: 0x35

    chord-note-on-delay-4:
      parameters:
        - delay:       # targeting +/- 300 mSec
            units: mSec
            range: [-300, 300]  # 6 bits
            steps_per_unit: 10
      control_change: 0x36

    chord-note-off-delay-4:
      parameters:
        - delay:       # targeting +/- 300 mSec
            units: mSec
            range: [-300, 300]  # 6 bits
            steps_per_unit: 10
      control_change: 0x37

    chord-vol-5:
      parameters:
        - offset:       # targeting +/- 20 dB
            range: [-20, 20]    # 6 bits
            steps_per_unit: 1
            units: dB
      control_change: 0x38

    chord-note-on-delay-5:
      parameters:
        - delay:       # targeting +/- 300 mSec
            units: mSec
            range: [-300, 300]  # 6 bits
            steps_per_unit: 10
      control_change: 0x39

    chord-note-off-delay-5:
      parameters:
        - delay:       # targeting +/- 300 mSec
            units: mSec
            range: [-300, 300]  # 6 bits
            steps_per_unit: 10
      control_change: 0x3A


# vim: sw=2
