dangyogi/midi-expression/exp_console/sketch_leds/col_ports_maps.h

// col_ports_maps.h

void col_on(col_ports_t *col, byte col_num) {
  switch (col_num) {     // 76543210
  case  0: col->port_c |= 0b00010000; break;
  case  1: col->port_c |= 0b00100000; break;
  case  2: col->port_c |= 0b01000000; break;
  case  3: col->port_b |= 0b00000100; break;
  case  4: col->port_e |= 0b00001000; break;
  case  5: col->port_b |= 0b00000001; break;
  case  6: col->port_b |= 0b00000010; break;
  case  7: col->port_e |= 0b00000001; break;
  case  8: col->port_e |= 0b00000010; break;
  case  9: col->port_d |= 0b00100000; break;
  case 10: col->port_d |= 0b00010000; break;
  case 11: col->port_d |= 0b00000001; break;
  case 12: col->port_d |= 0b00000010; break;
  case 13: col->port_d |= 0b00000100; break;
  case 14: col->port_d |= 0b00001000; break;
  case 15: col->port_d |= 0b10000000; break;
  }
}

void col_off(col_ports_t *col, byte col_num) {
  switch (col_num) {      // 76543210
  case  0: col->port_c &= ~0b00010000; break;
  case  1: col->port_c &= ~0b00100000; break;
  case  2: col->port_c &= ~0b01000000; break;
  case  3: col->port_b &= ~0b00000100; break;
  case  4: col->port_e &= ~0b00001000; break;
  case  5: col->port_b &= ~0b00000001; break;
  case  6: col->port_b &= ~0b00000010; break;
  case  7: col->port_e &= ~0b00000001; break;
  case  8: col->port_e &= ~0b00000010; break;
  case  9: col->port_d &= ~0b00100000; break;
  case 10: col->port_d &= ~0b00010000; break;
  case 11: col->port_d &= ~0b00000001; break;
  case 12: col->port_d &= ~0b00000010; break;
  case 13: col->port_d &= ~0b00000100; break;
  case 14: col->port_d &= ~0b00001000; break;
  case 15: col->port_d &= ~0b10000000; break;
  }
}

// The unused bits in each port are always 0 here.
const col_ports_t Decode_low[] PROGMEM = {
  {0b00000000, 0b00000000, 0b00000000, 0b00000000},   // 0
  {0b00000000, 0b00000000, 0b00000000, 0b00000001},   // 1
  {0b00000000, 0b00000010, 0b00000000, 0b00000000},   // 2
  {0b00000000, 0b00000010, 0b00000000, 0b00000001},   // 3
  {0b00000000, 0b00000001, 0b00000000, 0b00000000},   // 4
  {0b00000000, 0b00000001, 0b00000000, 0b00000001},   // 5
  {0b00000000, 0b00000011, 0b00000000, 0b00000000},   // 6
  {0b00000000, 0b00000011, 0b00000000, 0b00000001},   // 7
  {0b00000000, 0b00000000, 0b00000000, 0b00001000},   // 8
  {0b00000000, 0b00000000, 0b00000000, 0b00001001},   // 9
  {0b00000000, 0b00000010, 0b00000000, 0b00001000},   // 10
  {0b00000000, 0b00000010, 0b00000000, 0b00001001},   // 11
  {0b00000000, 0b00000001, 0b00000000, 0b00001000},   // 12
  {0b00000000, 0b00000001, 0b00000000, 0b00001001},   // 13
  {0b00000000, 0b00000011, 0b00000000, 0b00001000},   // 14
  {0b00000000, 0b00000011, 0b00000000, 0b00001001},   // 15
  {0b00000000, 0b00000100, 0b00000000, 0b00000000},   // 16
  {0b00000000, 0b00000100, 0b00000000, 0b00000001},   // 17
  {0b00000000, 0b00000110, 0b00000000, 0b00000000},   // 18
  {0b00000000, 0b00000110, 0b00000000, 0b00000001},   // 19
  {0b00000000, 0b00000101, 0b00000000, 0b00000000},   // 20
  {0b00000000, 0b00000101, 0b00000000, 0b00000001},   // 21
  {0b00000000, 0b00000111, 0b00000000, 0b00000000},   // 22
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
  {0b00011100, 0b00000000, 0b00000000, 0b00000000},   // 38
  {0b10011100, 0b00000000, 0b00000000, 0b00000000},   // 39
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
};

const col_ports_t Masks_high = {   // 1 bits are not used by any of the high columns
  0b01000000, 0b11111111, 0b11111111, 0b11111101, 
};
