dangyogi/midi-expression/exp_console/sketch_leds/Alpha_decoder.h

// Alpha_decoder.h

const col_ports_t Alpha_decoder[] = {
  {0b00010101, 0b00000101, 0b01110000, 0b00001010},    // 0x0 '\x00' <unknown>
  {0b00010101, 0b00000101, 0b01110000, 0b00001010},    // 0x1 '\x01' <unknown>
  {0b00010101, 0b00000101, 0b01110000, 0b00001010},    // 0x2 '\x02' <unknown>
  {0b00010101, 0b00000101, 0b01110000, 0b00001010},    // 0x3 '\x03' <unknown>
  {0b00010101, 0b00000101, 0b01110000, 0b00001010},    // 0x4 '\x04' <unknown>
  {0b00010101, 0b00000101, 0b01110000, 0b00001010},    // 0x5 '\x05' <unknown>
  {0b00010101, 0b00000101, 0b01110000, 0b00001010},    // 0x6 '\x06' <unknown>
  {0b00010101, 0b00000101, 0b01110000, 0b00001010},    // 0x7 '\x07' <unknown>
  {0b00010101, 0b00000101, 0b01110000, 0b00001010},    // 0x8 '\x08' <unknown>
  {0b00000000, 0b00000000, 0b00000000, 0b00000000},    // 0x9 '\t'
  {0b00010101, 0b00000101, 0b01110000, 0b00001010},    // 0xa '\n' <unknown>
  {0b00010101, 0b00000101, 0b01110000, 0b00001010},    // 0xb '\x0b' <unknown>
  {0b00010101, 0b00000101, 0b01110000, 0b00001010},    // 0xc '\x0c' <unknown>
  {0b00010101, 0b00000101, 0b01110000, 0b00001010},    // 0xd '\r' <unknown>
  {0b00010101, 0b00000101, 0b01110000, 0b00001010},    // 0xe '\x0e' <unknown>
  {0b00010101, 0b00000101, 0b01110000, 0b00001010},    // 0xf '\x0f' <unknown>
  {0b00010101, 0b00000101, 0b01110000, 0b00001010},    // 0x10 '\x10' <unknown>
  {0b00010101, 0b00000101, 0b01110000, 0b00001010},    // 0x11 '\x11' <unknown>
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
  {0b00010101, 0b00000000, 0b00000000, 0b00000010},    // 0x78 'x'
  {0b00010010, 0b00000000, 0b00000000, 0b00000010},    // 0x79 'y'
  {0b00010100, 0b00000100, 0b00010000, 0b00000000},    // 0x7a 'z'
  {0b00010001, 0b00000010, 0b00000000, 0b00000000},    // 0x7b '{'
  {0b00100010, 0b00000000, 0b00000000, 0b00000000},    // 0x7c '|'
  {0b00000100, 0b00000000, 0b00000000, 0b00000011},    // 0x7d '}'
  {0b00000000, 0b00000001, 0b00100000, 0b00000010},    // 0x7e '~'
  {0b00010101, 0b00000101, 0b01110000, 0b00001010}     // 0x7f '\x7f' <unknown>
};
