dangyogi/midi-expression/exp_console/sketch_master/notes.ino

// notes.ino

#define SW_TO_NOTE_NUM(sw)   (sw - (sw < FIRST_BUTTON ? FIRST_SWITCH : FIRST_BUTTON))

byte EEPROM_notes_offset;

// indexed by SW_TO_NOTE_NUM
byte MIDI_note[] = {57, 60, 64, 67, 70, 72};  // A3, C4, E4, G4, Bb4, C5

byte Notes_currently_on;  // Set/Reset during pulsing

void note_on_by_bt(byte sw) {
  byte note = SW_TO_NOTE_NUM(sw);
  // Switch takes precedence over button...
  if (!Switches[NOTE_SWITCH(note)].current) note_on(note);
}

void note_off_by_bt(byte sw) {
  byte note = SW_TO_NOTE_NUM(sw);
  // Switch takes precedence over button...
  if (!Switches[NOTE_SWITCH(note)].current) note_off(note);
}

void note_on_by_sw(byte sw) {
  byte note = SW_TO_NOTE_NUM(sw);
  if (CONTINUOUS_ON) {
    if (!Switches[NOTE_BUTTON(note)].current) note_on(note);
  } else {
    // Pulse mode!  Make sure pulsing is on...
    turn_on_periodic_fun(PULSE_NOTES_ON, PULSE_NOTES_PERIOD);
    turn_on_periodic_fun(PULSE_NOTES_OFF, PULSE_NOTES_PERIOD);
    if (Notes_currently_on) note_on(note);
  }
}

void note_off_by_sw(byte sw) {
  byte note = SW_TO_NOTE_NUM(sw);
  if (!Switches[NOTE_BUTTON(note)].current && (CONTINUOUS_ON || Notes_currently_on)) {
    note_off(note);
  }
  if (!CONTINUOUS_ON) check_pulse_off();
}

void check_pulse_on(void) {
  // If any note switches are on, turn on pulsing!
  //
  // Called when Continuous changed to Pulse, so any note switches that are on are currently playing.
  byte i;
  byte pulse_enabled = 0;
  for (i = 0; i < NUM_NOTES; i++) {
    if (Switches[NOTE_SWITCH(i)].current) {
      // Some note switch is on, make sure pulsing is on
      if (!pulse_enabled) {
        turn_on_periodic_fun(PULSE_NOTES_ON, PULSE_NOTES_PERIOD);
        turn_on_periodic_fun(PULSE_NOTES_OFF, PULSE_NOTES_PERIOD);
        if (Periodic_next[PULSE_NOTES_ON] - Periodic_next[PULSE_NOTES_OFF] < 35000) {
          // Next periodic is PULSE_NOTES_OFF.  Leave notes on!
          break;
        }
        pulse_enabled = 1;
      }
      note_off(i);
    } // end if (note sw on)
  } // end for (i)
}

void check_pulse_off(void) {
  // If all note switches are off now, turn off pulsing.
  byte i;
  for (i = 0; i < NUM_NOTES; i++) {
    if (Switches[NOTE_SWITCH(i)].current) {
      // Some note switch is on, so don't turn off pulsing yet
      return;
    }
  } // end for (i)
  // No note switch is on, turn off pulsing
  turn_off_periodic_fun(PULSE_NOTES_ON);
  turn_off_periodic_fun(PULSE_NOTES_OFF);
}

void note_on(byte note) {
  // Always channel 1
  usbMIDI.sendNoteOn(MIDI_note[note], 50, 1, SYNTH_CABLE);        // note, velocity, channel, cable
}

void note_off(byte note) {
  // Always channel 1
  usbMIDI.sendNoteOff(MIDI_note[note], 0, 1, SYNTH_CABLE);      // note, velocity, channel, cable
  //usbMIDI.sendNoteOn(MIDI_note[note], 0, 1, SYNTH_CABLE);
}

void notes_on(void) {
  byte i;
  if (!Notes_currently_on) {
    for (i = 0; i < NUM_NOTES; i++) {
      if (Switches[NOTE_SWITCH(i)].current) {
        note_on(i);
      }
    }
    Notes_currently_on = 1;
  }
}

void notes_off(void) {
  byte i;
  if (Notes_currently_on) {
    for (i = 0; i < NUM_NOTES; i++) {
      if (Switches[NOTE_SWITCH(i)].current) {
        note_off(i);
      }
    }
    Notes_currently_on = 0;
  }
}

void control_change(byte channel, byte control, byte value, byte cable) {
  usbMIDI.sendControlChange(control, value, channel + 1, cable);
}

unsigned short Last_nrpn[NUM_CHANNELS][2];

void nrpn_change(byte channel, unsigned short param_num, unsigned short value, byte cable) {
  if (param_num != Last_nrpn[channel][cable]) {
    usbMIDI.beginNrpn(param_num, channel + 1, cable);
    Last_nrpn[channel][cable] = param_num;
  }
  usbMIDI.sendNrpnValue(value, channel + 1, cable);
  // usbMIDI.endNrpn(channel + 1, cable);
}

void flush_midi(void) {
  usbMIDI.send_now();
}

byte setup_notes(byte EEPROM_offset) {
  EEPROM_notes_offset = EEPROM_offset;
  byte i;
  for (i = 0; i < NUM_NOTES; i++) {
    Switch_closed_event[NOTE_BUTTON(i)] = NOTE_BT_ON;
    Switch_opened_event[NOTE_BUTTON(i)] = NOTE_BT_OFF;
    Switch_closed_event[NOTE_SWITCH(i)] = NOTE_SW_ON;
    Switch_opened_event[NOTE_SWITCH(i)] = NOTE_SW_OFF;
  }
  Switch_closed_event[CONTINUOUS_PULSE_SW] = CONTINUOUS;
  Switch_opened_event[CONTINUOUS_PULSE_SW] = PULSE;
  return 0;  // for now...
}

// vim: sw=2
