dangyogi/midi-expression/exp_console/sketch_master/switches.h

// switches.h

#define NUM_ROWS         9
#define NUM_COLS         9

#define NUM_SWITCHES    81

#define SWITCH_NUM(row, col)    ((row) * NUM_COLS + (col))
#define SAVE_PROGRAM_SWITCH     SWITCH_NUM(1, 5)
#define SAVE_OR_SYNTH           (Switches[SAVE_PROGRAM_SWITCH].current)

#define FIRST_HARMONIC_SWITCH   SWITCH_NUM(4, 0)

// starting at 0
#define SWITCH_TO_HARMONIC(sw)  ((sw) - FIRST_HARMONIC_SWITCH)
#define HARMONIC_TO_SWITCH(hm)  (FIRST_HARMONIC_SWITCH + (hm))

#define FIRST_CHANNEL_SWITCH    SWITCH_NUM(6, 0)

// starting at 0 for CH-1 switch, Synth switch is 15
#define SWITCH_TO_CHANNEL(sw)   ((sw) == FIRST_CHANNEL_SWITCH ? 15 : (sw) - FIRST_CHANNEL_SWITCH - 1)
#define CHANNEL_TO_SWITCH(ch)   ((ch) == 15 ? FIRST_CHANNEL_SWITCH : FIRST_CHANNEL_SWITCH + (ch) + 1)

typedef struct {
  byte current;                 // 0 == open, 1 == closed
  byte last_seen;               // for debounce: 0 == open, 1 == closed
  byte open_time_set;
  byte close_time_set;
  byte debounce_index;          // 0 (switch) or 1 (encoder)
  byte tag;                     // for use by other parts of the software
  unsigned long open_time;      // last time switch opened
  unsigned long close_time;     // last time switch closed
} switch_t;

extern switch_t Switches[NUM_SWITCHES];

extern byte Rows[];  // Row pins
extern byte Cols[];  // Col pins

extern unsigned short Debounce_period[2];    // long (switches), short (encoders) uSec
extern void set_debounce_period(byte debounce_index, unsigned short dp);

extern byte setup_switches(byte EEPROM_offset);

extern unsigned long Longest_scan;             // uSec
extern unsigned long Longest_open_bounce[2];   // uSec, indexed by debounce_index
extern unsigned long Shortest_close_bounce[2]; // uSec, indexed by debounce_index
extern unsigned long Longest_wire_clear;       // uSec

#define MAX_DEBOUNCE_COUNT    30
extern byte Debounce_delay_counts[2][MAX_DEBOUNCE_COUNT + 1];   // debounce_index, mSec

extern byte Close_counts[NUM_SWITCHES];

extern void scan_switches(byte trace=0, byte trace_col=0);

// vim: sw=2
