dangyogi/midi-expression/exp_console/sketch_master/triggers.ino

// triggers.ino

byte EEPROM_triggers_offset;

// {switch_, button, led, check_event}
trigger_t Triggers[NUM_TRIGGERS] = {  // pot triggers share same array index as Num_pots/Pots arrays.
  { 0,  9, 167, CHECK_POTS},      // 1st Note
  { 1, 10, 166, CHECK_POTS},      // 2nd Note
  { 2, 11, 165, CHECK_POTS},      // 3rd Note
  { 3, 12, 164, CHECK_POTS},      // 4th Note
  { 4, 13, 163, CHECK_POTS},      // 5th Note
  {34, 47, 171, CHECK_POTS},      // vol note_on/off
  {33, 46, 170, CHECK_FUNCTIONS}, // functions
};

byte Num_pots[NUM_POT_TRIGGERS] = {3, 3, 3, 3, 3, 3};
byte Pots[NUM_POT_TRIGGERS][MAX_TRIGGER_POTS] = {
  { 0,  1,  2},  // 1st Note
  { 3,  4,  5},  // 2nd Note
  { 6,  7,  8},  // 3rd Note
  { 9, 10, 11},  // 4th Note
  {12, 13, 14},  // 5th Note
  {17, 18, 19},  // vol note_on/off
};

// 0xFF means no trigger == always continuous!
byte Pot_trigger[NUM_POTS];   // initialized from Triggers/Pots in setup_triggers

// Called when Channel or Harmonic switches change.
void disable_triggers(void) {
  byte i;
  for (i = 0; i < NUM_TRIGGERS; i++) {
    if (Triggers[i].continuous) {
      Triggers[i].continuous = 0;
      led_off(Triggers[i].led);
    }
  }
}

// Called when one of the monitored pot values for the trigger changes.
void pot_changed(byte pot) {
  if (Pot_trigger[pot] == 0xFF || Triggers[Pot_trigger[pot]].continuous) {
    send_pot(pot);
  }
}

// Called when trigger button is pressed.  Value may (or may not) have changed.
void check_trigger(byte trigger) {
  run_event(Triggers[trigger].check_event, trigger);
}

byte setup_triggers(byte EEPROM_offset) {
  EEPROM_triggers_offset = EEPROM_offset;
  byte tr, pot;
  for (tr = 0; tr < NUM_TRIGGERS; tr++) {
    Switches[Triggers[tr].switch_].tag = tr;
    Switch_closed_event[Triggers[tr].switch_] = TRIGGER_SW_ON;
    Switch_opened_event[Triggers[tr].switch_] = TRIGGER_SW_OFF;

    Switches[Triggers[tr].button].tag = tr;
    Switch_closed_event[Triggers[tr].button] = TRIGGER_BT_PRESSED;
    Switch_opened_event[Triggers[tr].button] = TRIGGER_BT_RELEASED;

    for (pot = 0; pot < NUM_POTS; pot++) {
      Pot_trigger[pot] = 0xFF;
    }
    if (Triggers[tr].check_event == CHECK_POTS) {
      for (pot = 0; pot < Num_pots[tr]; pot++) {
        Pot_trigger[pot] = tr;
      }
    }
  }
  return 0;
}


// vim: sw=2
