dangyogi/midi-expression/exp_console/sketch_leds/alpha_displays.h

// alpha_displays.h

#define MAX_NUM_STRINGS     4
#define MAX_STRING_LEN      30
#define END_GAP             3
#define SCROLL_DELAY        250  /* mSec */

extern byte EEPROM_Num_alpha_strings(void);
extern byte EEPROM_Alpha_num_chars(byte string_num);
extern byte EEPROM_Alpha_index(byte string_num);

extern byte Num_alpha_strings;
extern byte Alpha_num_chars[MAX_NUM_STRINGS];
extern byte Alpha_index[MAX_NUM_STRINGS];

extern byte setup_alpha_displays(byte my_EEPROM_offset);

extern void load_string(byte string_num, char *s);

unsigned short test_alpha_decoder(void);

// Timeout function: Returns how long to wait until next call (mSec).
extern unsigned short advance_strings(void);

// vim: sw=2
