dangyogi/midi-expression/(commit log)

2022-04-21 Switched to queues for MIDI events. No longer drops MIDI events!
2022-05-08 Added empty funs for each control change, wired to distribution code.
2022-05-14 Added cents_per_octave to tuning_systems to get fudged octaves.
    Not fully tested yet, but passing all current tests.
2022-05-23 gen_synth_settings.py starting to work (doesn't bomb)
    [synth_settings.py, synth_settings.yaml]
2022-05-29 Fixed setting bug, now clipping output to soundcard.
    [synth_settings.py, synth_settings.yaml]
2022-06-05 Checkpoint sketch_pots. Only one FIX left...
    Still haven't tested actual pot(s)...
    [exp_console.yaml, flash_errno.ino, scale_slide_pot.ino, sketch_pots.ino, sketch_test_lcd.ino]
2022-06-17 Got the wiring related stuff hopefully finalized.
2022-06-20 Renamed files in sketch_led/ to shorten their names.
    [alpha_displays.h, alpha_displays.ino, numeric_displays.h, numeric_displays.ino, sketch_leds.ino]
2022-06-21 Looks like sketch_pots is working! (and tested, except for I2C)
2022-06-24 Testing first switch col for sketch_master.
2022-07-16 Checkpoint conversion to teensy. Just needs to be compiled and tested...
2022-07-21 Added I2C tests from Serial to sketch_master to/from RAM controller.
2022-09-17 Added PCB layout files.
    [alpha-displays.kicad_pcb, alpha-displays.kicad_sch, calibration.kicad_pcb, calibration.kicad_sch, column-bus.kicad_pcb, column-bus.kicad_sch, numeric-displays.kicad_pcb, numeric-displays.kicad_sch]
2023-08-22 Snapshot debugging I2C --
    going to do significant changes to sketch_led.ino for sendReport
    so that it no longer queues it. The Wire library requires the sendReport
    processing (i.e., Wire.writes) to be complete before the function
    returns.
    [alpha_displays.ino, numeric_displays.ino, sketch_i2c_master.ino, sketch_i2c_slave.ino, sketch_leds.ino, sketch_master.ino, sketch_pots.ino, sketch_ram.ino]
2023-08-24 Got I2C working to LED controller, started driver.
2023-08-26 byte transfer tests work. driver initialization works.
2023-10-29 Added changes for new column mapping to Arduino pins.
    For PCB layout.
2023-10-30 Added easyEDA PCB file for LED Controller.
    [PCB_PCB_LED Controller_2023-10-30.json]
2023-11-29 New LED Controller board passing initial tests.
    [PCB_PCB_LED Controller_2023-10-30.json]
2023-11-30 Finished testing for LED Controller PCB.
2024-05-09 Checkpoint after replacing rotary encoders.
    Many changes not compiled yet...
2024-05-15 Last commit before new master controller board.
    Fixed encoder decode bug. Added Trace_encoders.
    [events.h, events.ino, sketch_master.ino]
2024-05-25 Added function encoder value memory and defaults...
    Seems to be working. Now at Master V37.
2024-06-10 Looks like Master <- Pots I2C is working now!
2024-06-12 Checkpoint: added midi_control.ino, but not wired in yet.
2024-07-29 Checkpoint on test_arduino.
    Compiles sketch_master on laptop. Need to add socket comms and stub functions...
2024-08-17 Fixed bug in sketch_master. Report encoders now incl min/max.
    [functions.ino, test_compile.yaml, test_driver.py]
2024-08-17 Fixed display of final 'returned' when not in verbose mode
    [test_driver.py]
2024-08-17 Added sendRequest history and fixed SIGSEGV in functions.ino
    [functions.ino, test_driver.py]
2024-08-26 Added Trace flag to turn_on_periodic_fun to shut down prints.
    This is sketch_master V61, loaded onto teensy.
    Also wrote snapshot sh script to capture all test output.
